brucejcooper/zigbee_rt100/temp_probe_zigbee/temp_probe_zigbee.kicad_sch

## KiCad design temp_probe_zigbee/temp_probe_zigbee.kicad_sch (2026-06-27)

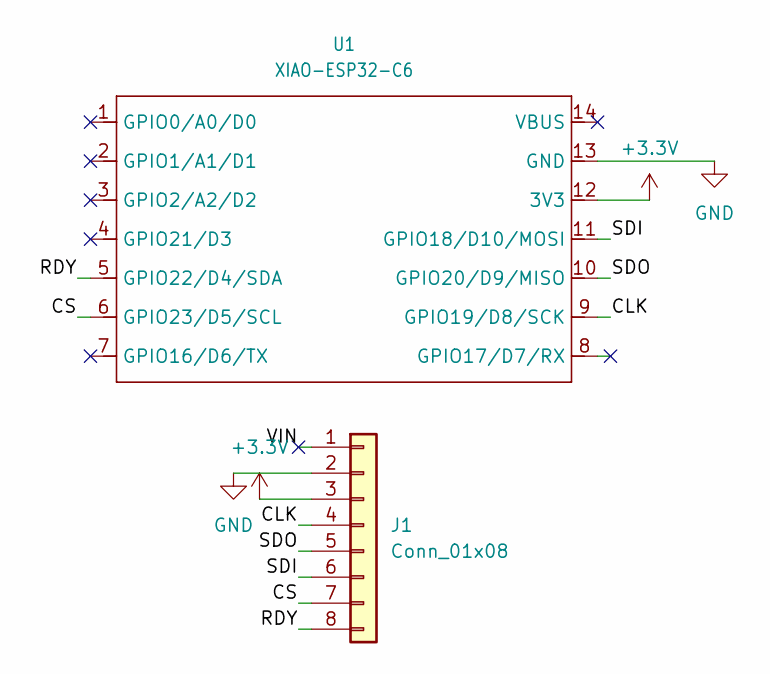
[picture p1: schematic temp_probe_zigbee.kicad_sch]

Parts:
J1: Conn_01x08; PinSocket_1x08_P2.54mm_Vertical
U1: XIAO-ESP32-C6; XIAO-ESP32C6-DIP

Connections:
+3.3V: J1.3, U1.12 (3V3)
CLK: J1.4, U1.9 (GPIO19/D8/SCK)
CS: J1.7, U1.6 (GPIO23/D5/SCL)
GND: J1.2, U1.13 (GND)
RDY: J1.8, U1.5 (GPIO22/D4/SDA)
SDI: J1.6, U1.11 (GPIO18/D10/MOSI)
SDO: J1.5, U1.10 (GPIO20/D9/MISO)
VIN: J1.1
