brucejcooper/zigbee_rt100/(commit log)

2026-06-20 Fix 0xFC00 diag cluster: register attrs as manufacturer-specific
    Cluster 0xFC00 is in the manufacturer-specific range, so z2m/
    zigbee-herdsman frames its reads and writes with a manufacturer
    code. The firmware registered the diagnostics attributes as plain
    (non-manufacturer-specific), so every read returned nothing and
    writes failed with NOT_AUTHORIZED.
    Register all seven diag attributes via
    esp_zb_cluster_add_manufacturer_attr() under TP_MANUF_CODE (0x1037,
    previously defined but unused), route the live fault-byte update
    through esp_zb_zcl_set_manufacturer_attribute_val(), and declare the
    matching manufacturerCode on the z2m converter cluster.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
    [temp_probe.c]
2026-06-20 Fix boot crash on manuf diag attrs; add device icon
    The previous commit registered the diag attributes manufacturer-specific
    but kept the REPORTING access flag. No reporting info is configured for
    the diag cluster, and the manufacturer-aware report path
    (zb_zcl_report_attr -> zb_zcl_get_next_reporting_info) dereferences a
    null when a value is set on such an attribute, panicking the device at
    boot during the first fault-byte update — so z2m interviews failed.
    Drop the unused REPORTING flag from the faultRaw and antenna attributes;
    they are read on demand (STATE_GET) and the live fault alarm already
    reports via the separate genBinaryInput cluster.
    Also embed the Mechination logo as a base6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
    [temp_probe.c]
2026-06-20 Fix diag cluster missing from simple descriptor; add factory-reset button
    Registering the 0xFC00 diag attributes as all-manufacturer-specific
    caused esp_zb_device_register to drop the cluster from the simple
    descriptor entirely, so z2m reported "has no input cluster
    mechinationDiag" and could neither read, write, nor configure it.
    Revert to plain custom attributes (esp_zb_custom_cluster_add_custom_attr),
    which is the canonical pattern and what gets the cluster emitted into the
    descriptor; revert the live fault-byte update to esp_zb_zcl_set_attribute_val;
    and drop the converter's manufacturerCode so both sides use plain framing.
    Also keep the device node-descriptor manufacturer code (0x1037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
    [temp_probe.c]
2026-06-21 Fix z2m exposes null: add name field to custom cluster attributes
    zigbee-herdsman uses each attribute definition's `name` property (not the
    JS object key) for the attribute-ID -> name reverse lookup when parsing
    read responses. The mechinationDiag attributes had no `name`, so reads came
    back keyed "undefined" and every diagnostic/antenna expose stayed null even
    though the device returned correct values.
    Add an explicit name to each attribute (matching the key) and mark antenna
    writable. Converter-only fix; firmware and device descriptor were correct.
2026-06-21 Fix z2m custom cluster name undefined: add name field to cluster definition
    deviceAddCustomCluster stores the definition as-is and herdsman uses the
    definition's `name` property as the cluster's name when parsing device
    messages. The definition had no `name` (only the positional first arg, which
    becomes the lookup key), so the cluster resolved with name `undefined`:
    device readResponses came through as cluster 'undefined', the fromZigbee
    converters (keyed cluster: 'mechinationDiag') never matched, configure failed
    ("has no input cluster mechinationDiag"), and every read-only expose stayed
    null. Writes worked because they don't go through that path.
    Add name: 'mechinationDiag' to the cluster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
2026-06-21 Lower default temperature reportable change to 0.05 C
    Change CONFIG_TP_REPORT_DELTA_CENTIDEG default from 20 (0.2 C) to 5
    (0.05 C) so the device reports finer temperature steps. Updated both the
    Kconfig default and the active sdkconfig value.
2026-06-21 Configure fine temperature reporting in z2m (0.05 C, 5 min heartbeat)
    z2m's m.temperature() default reporting (change: 100 = 1 C, max: 1 hour)
    overrides the device's firmware reporting via Configure Reporting, so the
    device only reported on a full 1 C change or the hourly heartbeat — the
    "big step once an hour" symptom.
    Override it to {min: 10s, max: 5min, change: 5} so z2m configures the
    device for 0.05 C steps (matching the firmware default) with a 5-minute
    heartbeat when stable.
2026-06-22 Add DRDY oversampling, move SPI CS/DRDY pins, USB-only console
    - MAX31865: interrupt-driven oversampling. DRDY (active-LOW) wakes the
    sampling task on every continuous conversion (~52/s); the task block-
    averages all conversions in each TP_SAMPLE_PERIOD_MS window and publishes
    the average, cutting jitter by ~sqrt(N) without lag. ulTaskNotifyTake
    timeout doubles as a stalled-DRDY fallback (degrades to one sample/window).
    - Move SPI off the console pins: CS D7/GPIO17 -> D5/GPIO23, add DRDY on
    D4/GPIO22. Verified on-device: config readback 0xd1, HighFaultThr 0xFFFF,
    ~13 conversions averaged per 250 ms window.
    - Console: USB Serial/JTAG only; drop duplicate UART0 console to free
    GP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
    [temp_probe.c]
2026-06-22 Replace block averaging with Zigbee-configurable EMA smoothing
    - Sampling: run an exponential moving average (y += alpha*(x-y)) on every
    DRDY conversion instead of averaging a fixed window. The MeasuredValue is
    continuously smoothed and always fresh; TP_SAMPLE_PERIOD_MS is now just the
    publish/refresh cadence, not an averaging window. EMA is seeded on the first
    good sample; a faulted read holds the last value.
    - alpha is now a writable diagnostics-cluster attribute (0xFC00 / 0x0021,
    UINT16 = alpha x 1000), clamped to [0.001, 1.0] and persisted to NVS.
    Power-on default 0.40 via CONFIG_TP_EMA_ALPHA_PERMILLE.
    - Remove the now-meaningless local-sample-period diagnostic (attr 0x0014).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
    [temp_probe.c, temp_probe.h]
2026-06-27 Report RTD fault as unavailable instead of a bogus temperature
    On an RTD fault the conversion can yield wildly wrong values (very negative
    or very high), corrupting graphs and any process consuming the reading.
    - Firmware: drop out-of-range samples (PT100/PT1000 physical span) so a
    garbage transition sample can't poison the EMA; on a fault, or when no
    trustworthy sample arrived in a publish period, write the ZCL invalid
    sentinel MeasuredValue=0x8000 and force a clean EMA re-seed on recovery.
    - Converter: override m.temperature fzConvert to map 0x8000 (-32768) to null
    (unavailable) rather than surfacing it as -327.68 C.
    Normal path verified on device (no spurious invalids); live fau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
    [temp_probe.c, temp_probe.h]
2026-06-27 Update KiCad design; ignore KiCad/JLCPCB local artifacts
    Commit the latest schematic/PCB/project edits. Ignore regenerable artifacts:
    auto-backups, *.kicad_prl, jlcpcb/ fab output, and stray *.rpt reports.
    Claude-Session: https://claude.ai/code/session_01PDqNxEFAhmrqW476w8fymk
    [temp_probe_zigbee.kicad_pcb, temp_probe_zigbee.kicad_sch]
2026-06-28 Migrate temp probe from Zigbee to WiFi + MQTT + Home Assistant discovery
    The probe now joins WiFi and talks MQTT directly so a plain ESP32 boil
    controller can consume its readings; Home Assistant auto-discovers it.
    - Replace the entire esp-zigbee stack with a WiFi station + esp-mqtt client.
    Keep the MAX31865 DRDY-driven EMA (alpha, default 0.40, writable + persisted).
    - Publish temperature at 1 Hz. On an RTD fault the temperature entity goes
    unavailable via its own availability topic; a broker Last Will (15 s
    keepalive) marks the whole device unavailable on an ungraceful drop, and the
    device publishes "online" on every (re)connect.
    - HA MQTT discovery for all entities under one devi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
    [partitions.csv]
